ieee-uiuc/arduino-workshop/README.md

# arduino-workshop

The home of the IEEE@UIUC Arduino Workshop! You can find each shield and example code in the appropriate directory.
