ieee-uiuc/arduino-workshop/hardware/Baseline_Shield/Baseline_Shield.md

# Baseline Shield
Arduino shield for the Baseline Arduino workshop, as well as the first breakout session.
  * 6 LED outputs (3 PWM allowed)
  * 2 Buttons (IEEE Logos)
  * Plug-and-play Spot for Servos
  * Other used pins go out to headers
