ieee-uiuc/arduino-workshop/slides/Arduino Workshop Breakout II.pdf

# Arduino Workshop Breakout II

# IEEE Arduino Workshop, Fall 2015 Kashev Dalmia & Brady Salz

Tell Me About You.

- What’s your Year in School?
- Have you Taken…
- ECE 220/190/198kl?
- CS 225?
- ECE 391?
- CS 431?
- ECE 445?
- ECE 310/311?
- Rate Your Experience With…
- Arduino
- C++
- DSP
- Building Stuff

This is us.

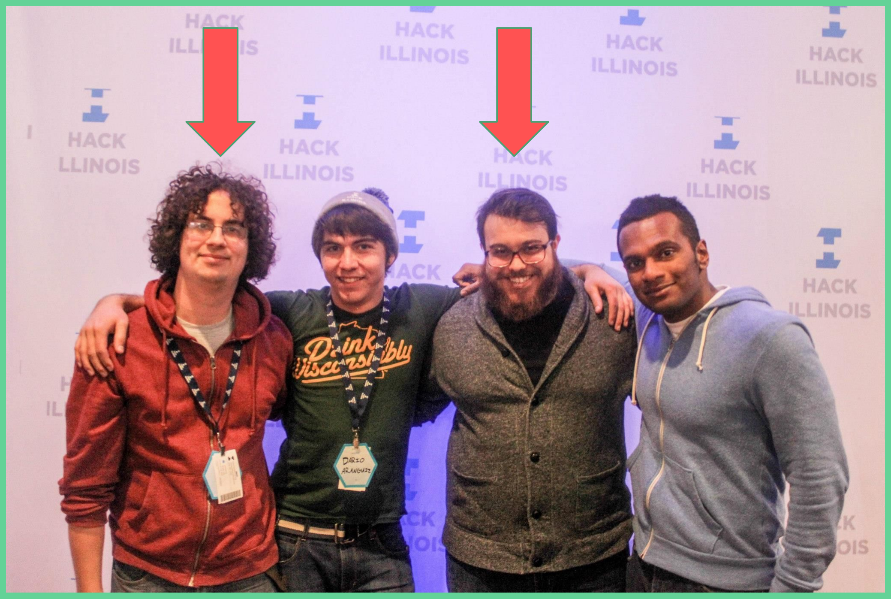
[picture p1: figure]

- Graduate Students
- Brady: Hardware
- Kashev: Software
- Been doing this sort of thing a while.

Today’s Agenda for Breakout II: Learn About...

# - Understanding Hardware+Software Systems - Interacting with more ‘Advanced’ Parts - Writing Good Software

# Understanding Hardware Systems

# Shield System Diagram (HW Design)

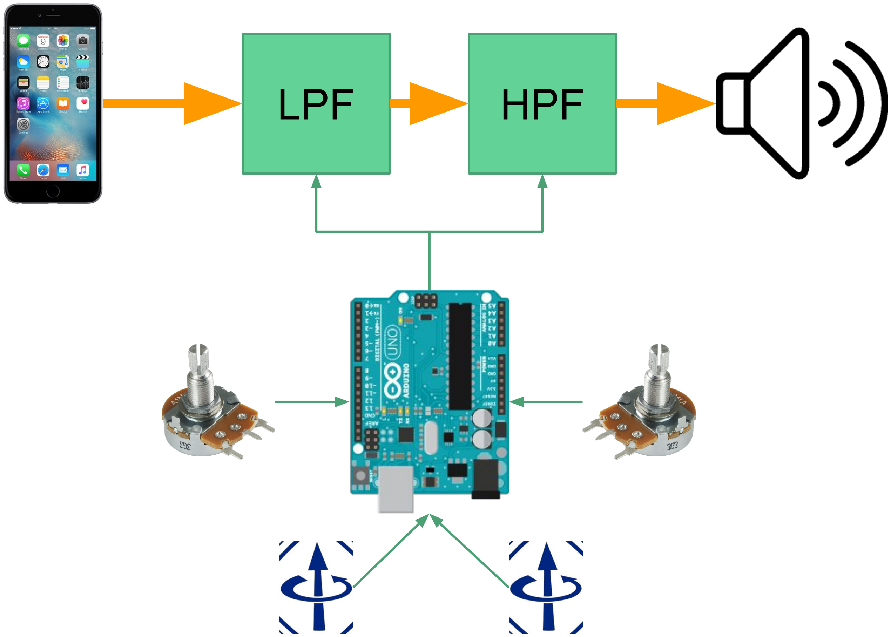
[picture p2: figure]
LPF; HPF

### - This is already done for you!

- Thanks, Brady

### - This is already assembled for you!

- Thanks, Team

### - Things to Think About:

- Why is the audio path not running through the Arduino?
- What are the Inputs to the Arduino?
- What are the Outputs of the Arduino?

# Shield Schematic Overview

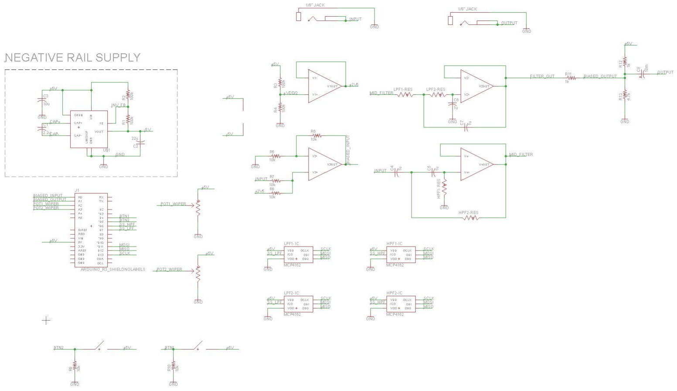
[picture p3: figure]

### - Potentiometers - Digital Resistors - Buttons - Rail Inverter - 2nd Order Filters

# Analog Filtering

### - Two Filters

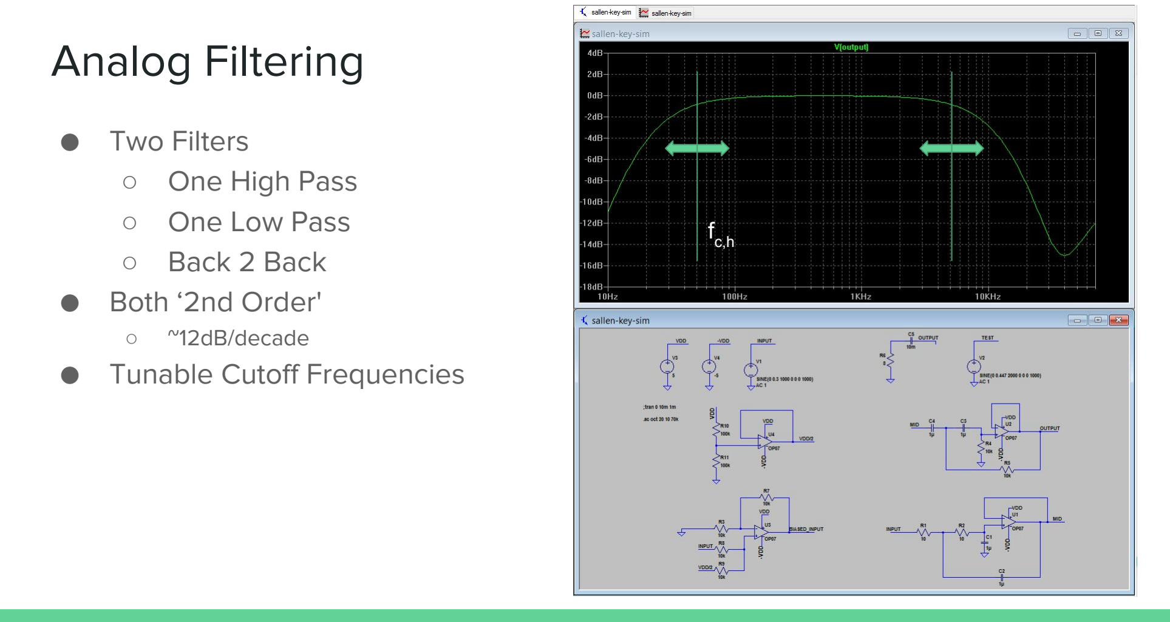
[picture p4: page 8]

### - One High Pass - One Low Pass - Back 2 Back - Both ‘2nd Order'

- ~12dB/decade

### - Tunable Cutoff Frequencies

fc,h

# Digital vs Analog Potentiometers?

### Digital Potentiometers

### - Pros

- Very, very high accuracy
- Very, very high precision

### - Cons

- Have to be programmed
- Low power rating

### Analog Potentiometers

### - Pros

- Fun to use!
- High power rating

### - Cons

- Low precision
- Low accuracy

# Our Goal: Filter The Audio Based On The Position of the

Potentiometers.
The Button States.

# Steps to Accomplish Goals:

### 1. Read The Button State 2. Adjust the Filter Cutoff Frequencies

# Sub-Steps to Accomplish Goals:

### 1. Read The Buttons

a. Read in as Digital Input.

### 2. Adjust the Filter Cutoff Frequency

a. Learn relationship between digital resistors & our filters.
b. Learn to talk to our filters.

# Controlling the Filters

### - Need to move filter cutoffs - -> Need to Change Resistor Values - Our Resistors are Microchip MCP4162s

- Thanks Brady!

### - So How Do We Learn How To Control These?

# Interacting with Advanced Parts

# How do we interact with Advanced Parts?

Read The Datasheet.

## http://ww1.microchip.com/downloads/en/DeviceDoc/22059b.pdf

### - This Datasheet is hard to digest:

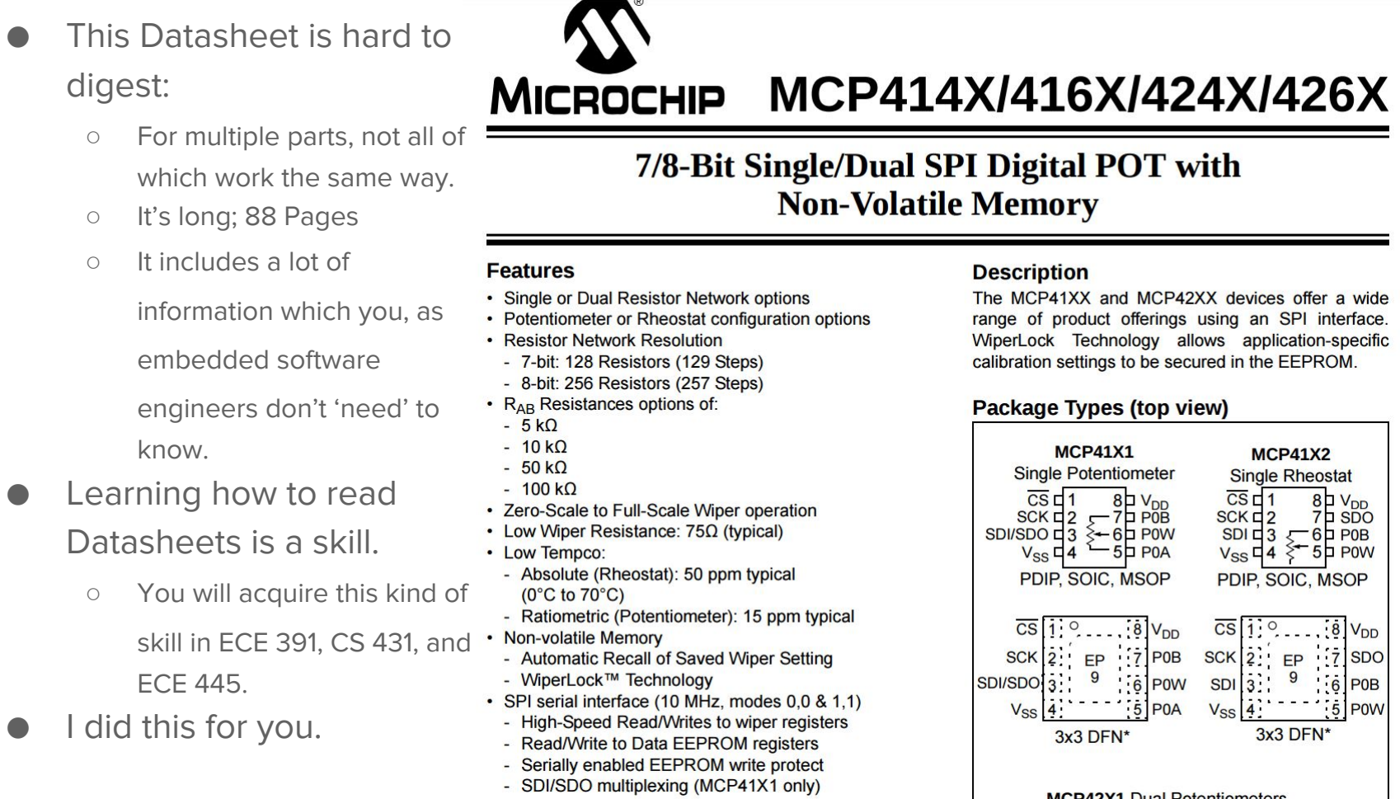
[picture p5: page 17]

- For multiple parts, not all of which work the same way.
- It’s long; 88 Pages
- It includes a lot of

information which you, as

embedded software

engineers don’t ‘need’ to
know.

### - Learning how to read

Datasheets is a skill.

- You will acquire this kind of

skill in ECE 391, CS 431, and ECE 445.
- I did this for you.

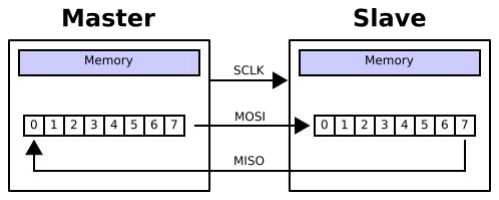
[picture p6: figure]

# Talking to SPI Parts

### - Master and Slave Devices

- Can have multiple slaves on the same SCLK/MOSI/MISO lines.
- Each slave has a chip select

which we can use to tell it to listen.

### - Kind of a loosely defined

protocol.

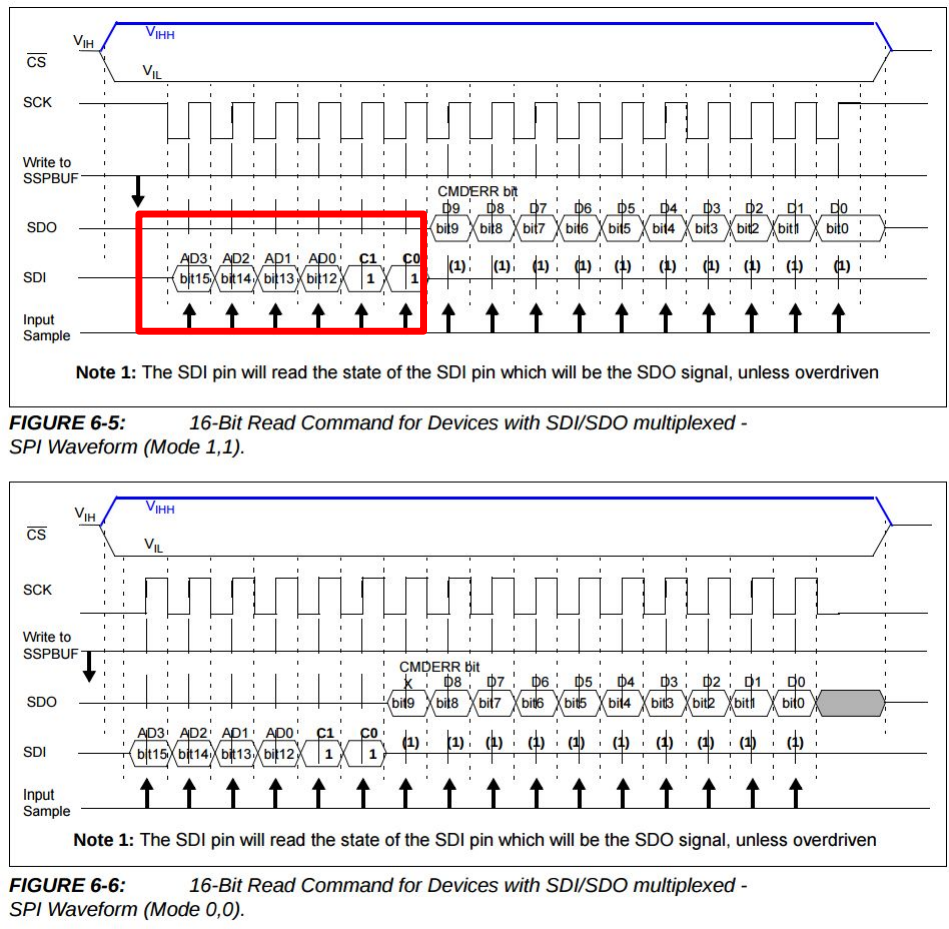
[picture p7: figure]

### - Reading the Datasheet:

- MSB First

### - Reading the Datasheet:

- MSB First
- Mode 11
- 10MHz operation

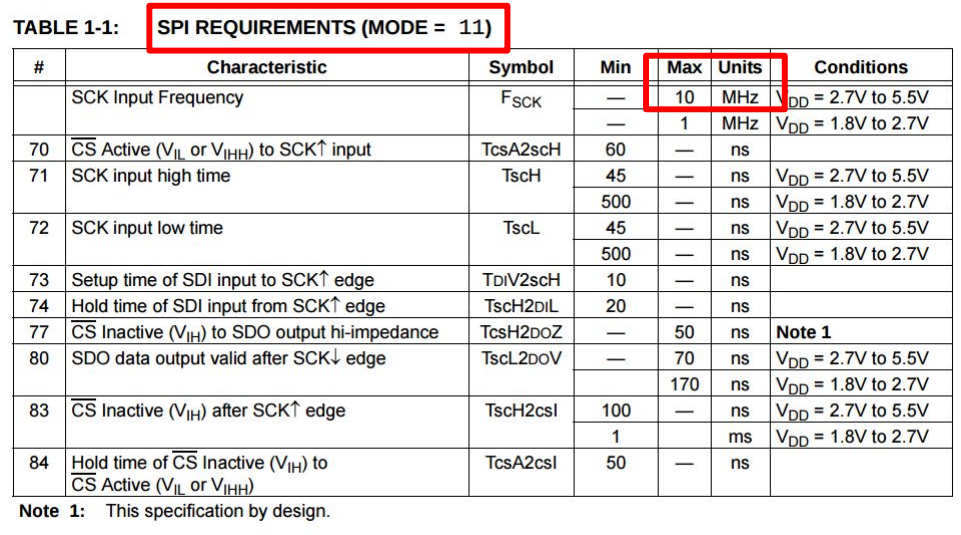
[picture p8: figure]

### - Reading the Datasheet:

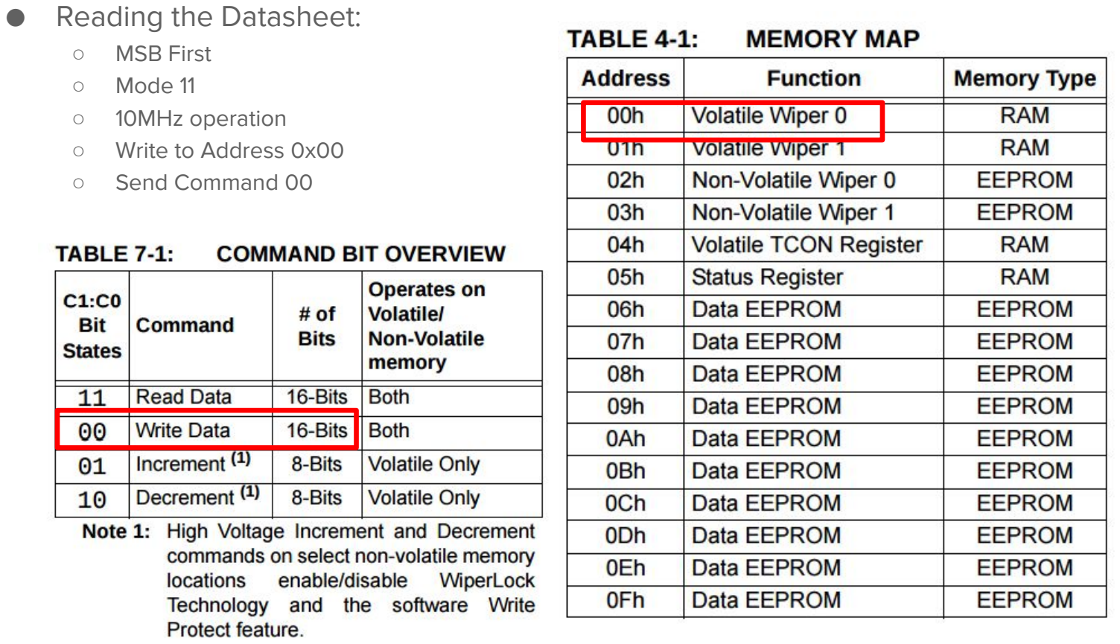
[picture p9: page 21]

- MSB First
- Mode 11
- 10MHz operation
- Write to Address 0x00
- Send Command 00

# So now we implement SPI, right?

# Rule of Software: Don’t Reinvent the Wheel

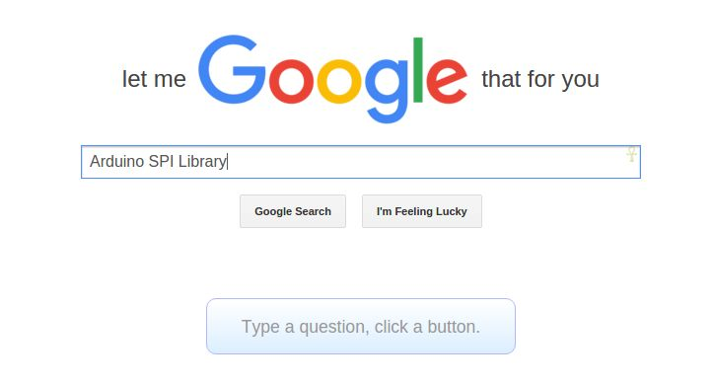
[picture p10: figure]

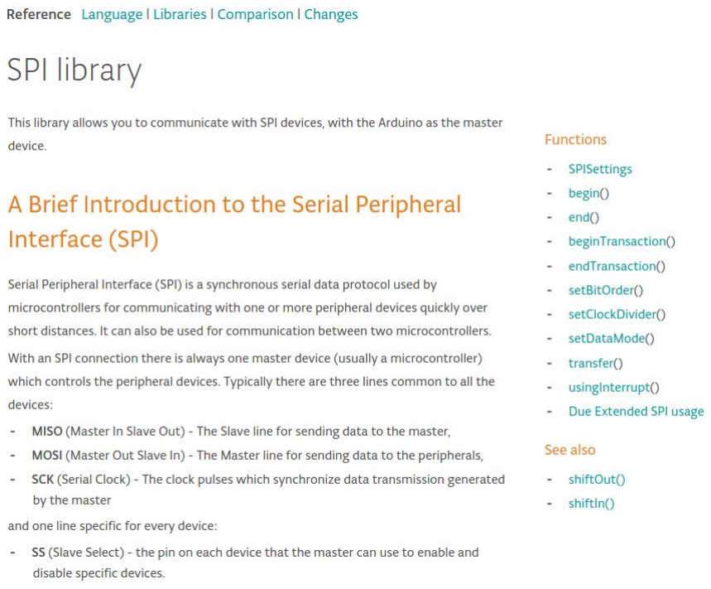
[picture p11: figure]

# Arduino SPI Library

### - Standard, shipping library - Good documentation by Arduino Standards

https://www.arduino.cc/en/Reference/SPI

# Aside: Device Communication Standards

- There are a lot of them.
- You generally should not invent your own communication protocol.
- You generally should not have to write your own communication library.
- SPI
- SSI
- CANN
- I2C
- I2S
- the list goes on and on and on and on

# Writing Good Software

# What Is Good Software?

### 1. Works 2. Readable 3. As Simple as Possible 4. Modular 5. Extensible

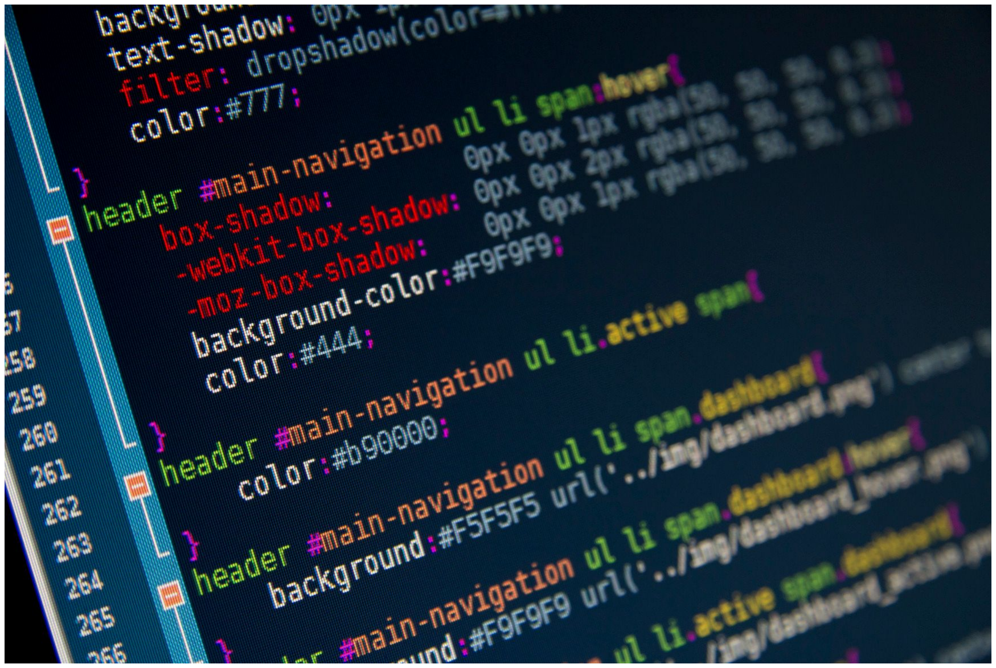
[picture p12: figure]

CSS is almost never good code.

# Why Do We Write Good Software?

### 1. Money

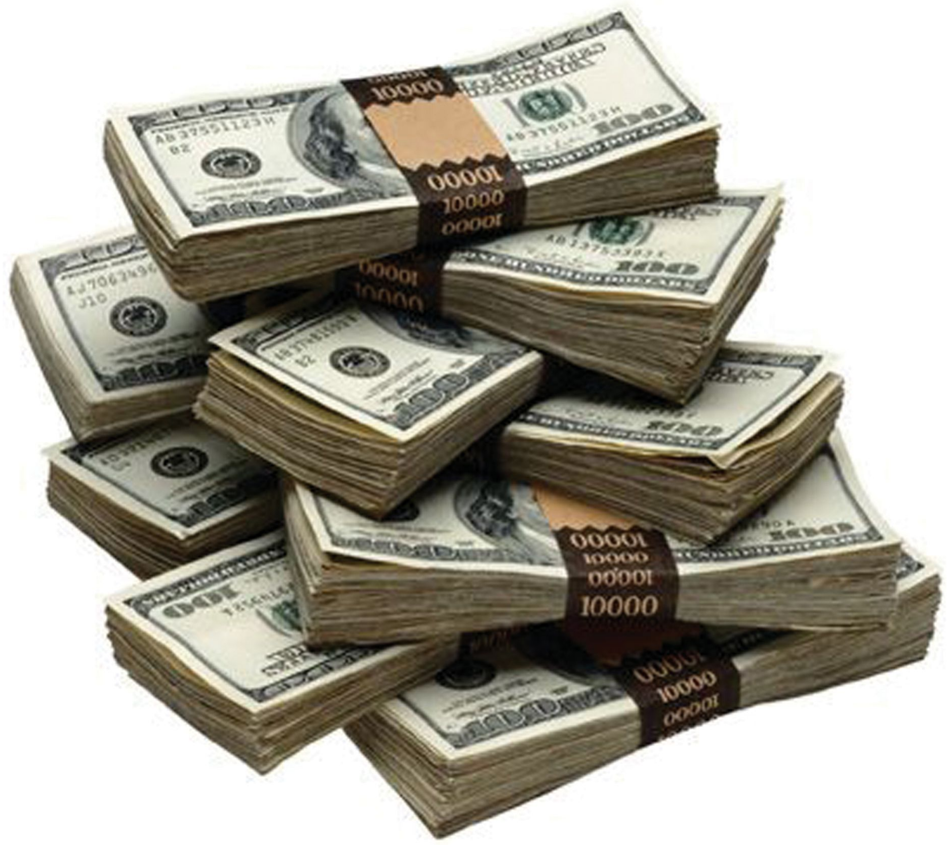
[picture p13: figure]

### 2. Pride 3. Kindness to Ourselves & Others

# Rule of Software: Adhere to A Style

### https://www.arduino.cc/en/Reference/APIStyleGuide

# Arduino: Not C++

# Arduino Uses OOP

### - Object Oriented Programming - Every Physical Thing should also be a Software Thing - You’ll learn about it in CS 225

Resistor | Resistor
LPF | HPF

Shield

# Let’s Talk About the Code

# Appendix + Errata: Using the Potentiometers

# The PCB Shields have a small error which we didn’t have

time to fix.

# Correctly Attaching The Pots

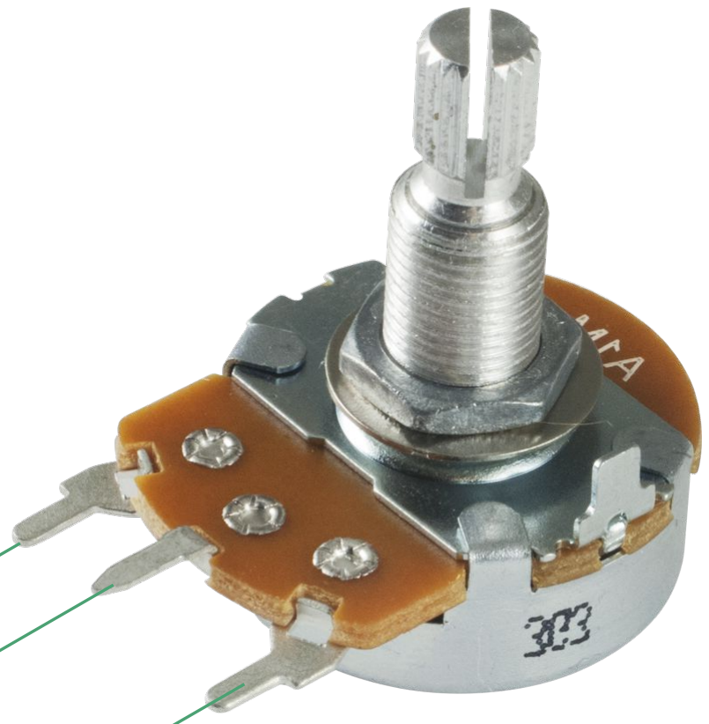
[picture p14: figure]

### Ironically, all the “hard” parts of the board

work fine.

### It’s the easiest part that got messed up

### I mislabeled the “W” and “B” pins

### The fix is simple, just rewire manually

### Simple for one board, obnoxious for fixing 30 of them

### Rework instructions online by end of today

A W
B

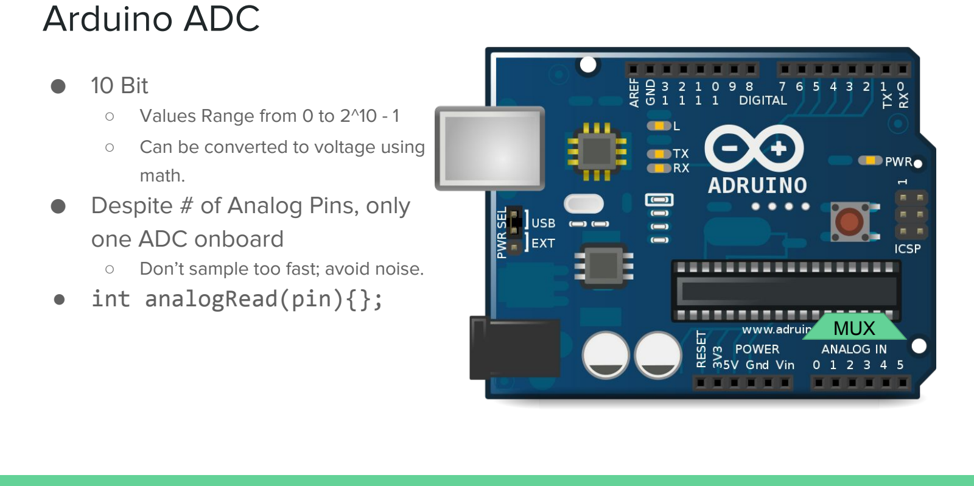
[picture p15: page 36]

Arduino ADC ● 10 Bit ○ | Values Range from 0 to 2^10 - 1 ○ | Can be converted to voltage using

math.

### - Despite # of Analog Pins, only

one ADC onboard ○ Don’t sample too fast; avoid noise.

- int analogRead(pin){};

MUX

### - The potentiometers on your shields are/were on pins A2, A3 - We’ll adapt a sketch to learn

how to do this.

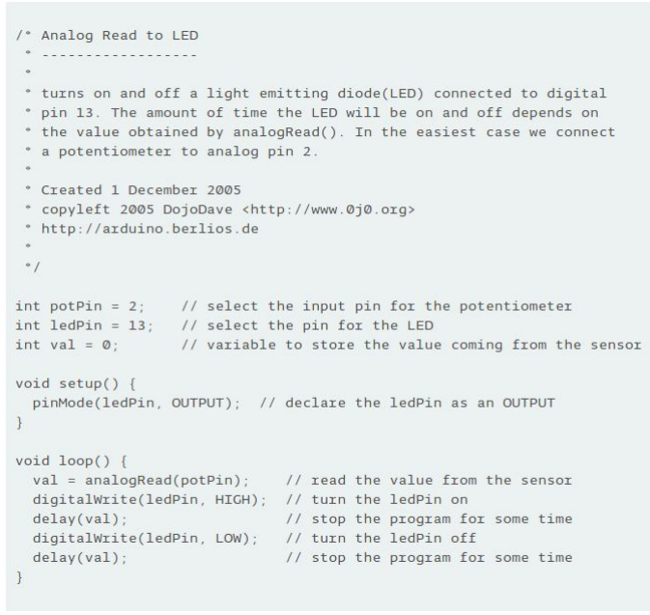
[picture p16: figure]

### arduino.cc/en/Tutorial/Potentiometer

# Reading a Potentiometer
