ieee-uiuc/arduino-workshop/hardware/Advanced_Shield/Advanced_Shield_Board.png

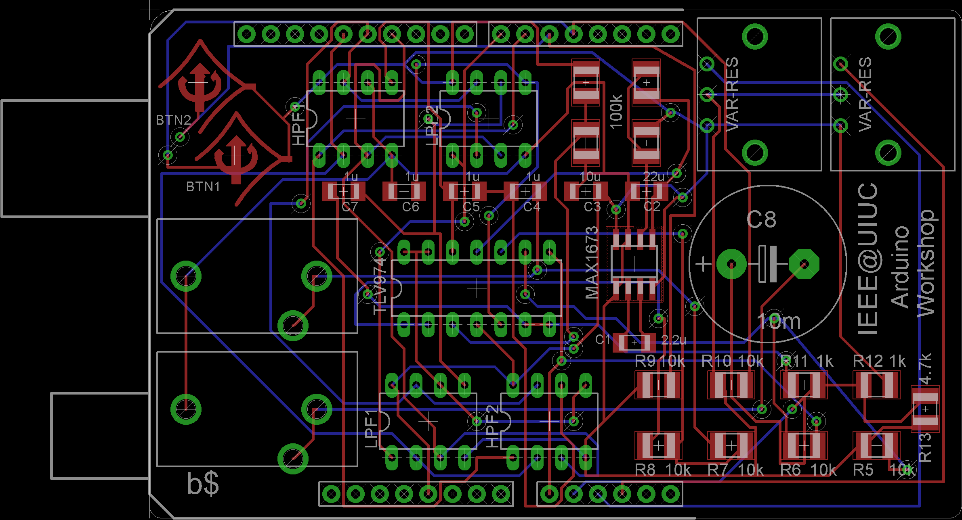
hardware/Advanced_Shield/Advanced_Shield_Board.png
