ieee-uiuc/arduino-workshop/hardware/Advanced_Shield/Advanced_Shield_Schematic.png

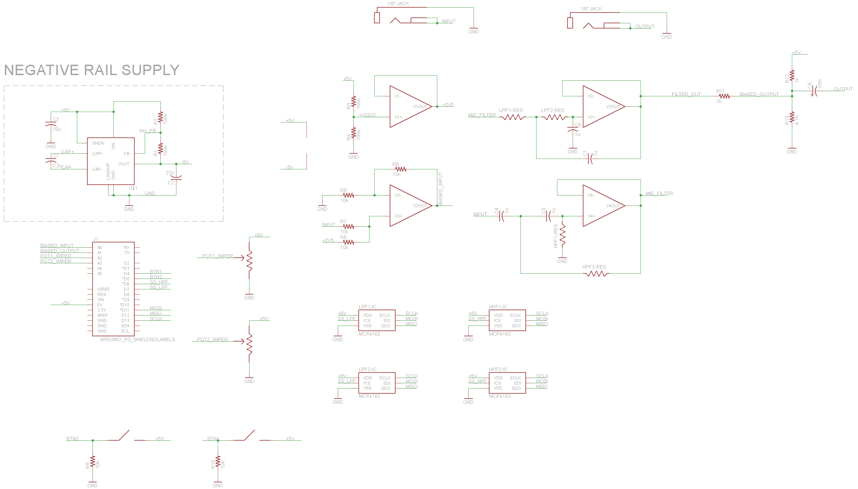
hardware/Advanced_Shield/Advanced_Shield_Schematic.png
