ieee-uiuc/arduino-workshop/hardware/Baseline_Shield/Baseline_Board_Schematic.png

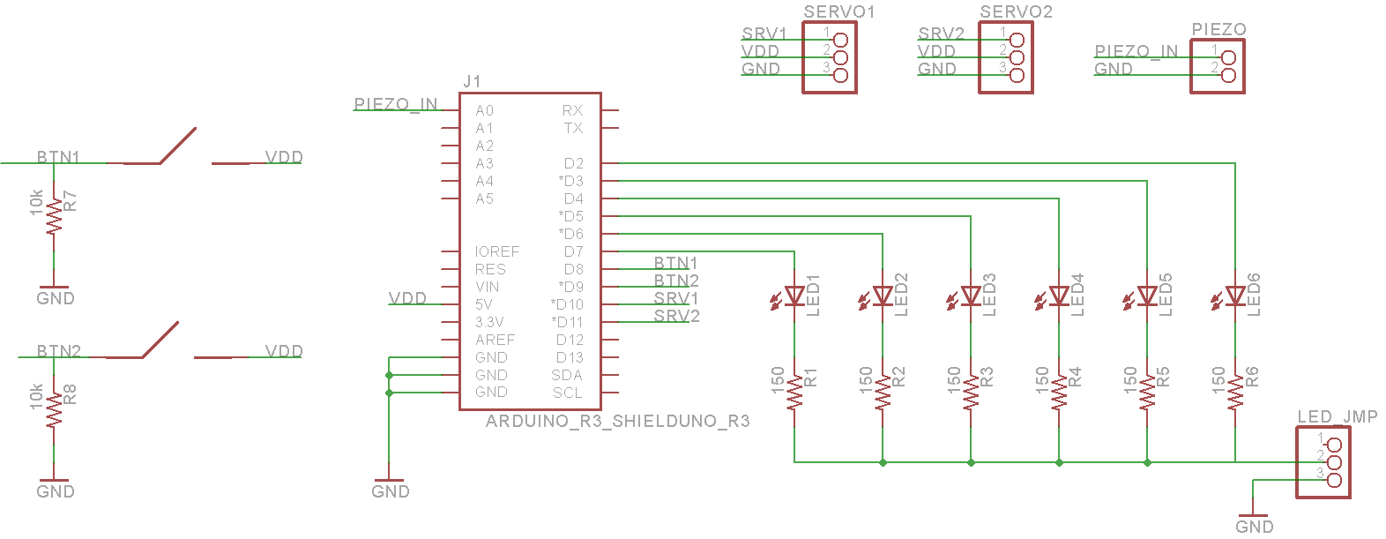
hardware/Baseline_Shield/Baseline_Board_Schematic.png
