ieee-uiuc/arduino-workshop/hardware/Baseline_Shield/Baseline_Shield_Board.png

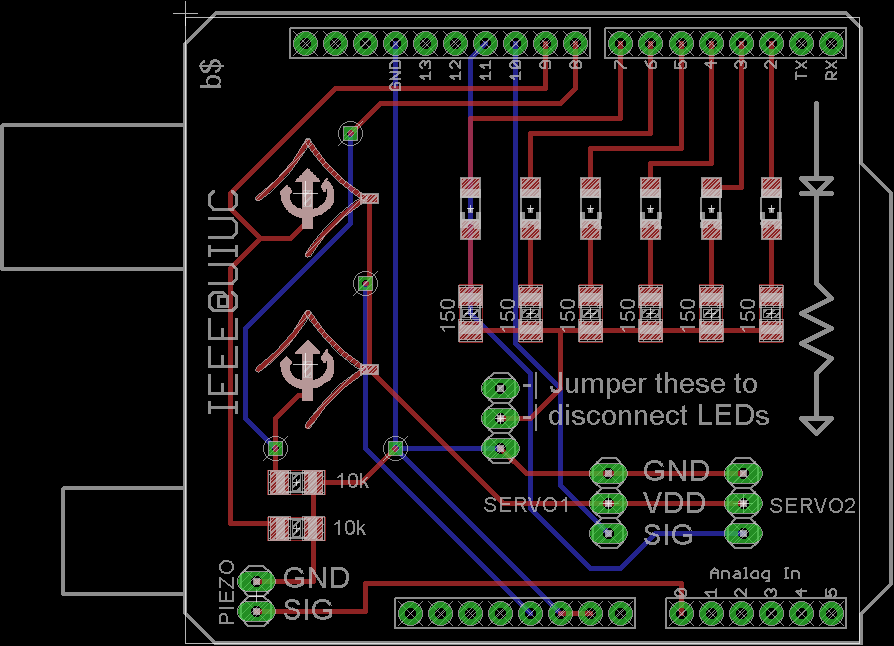
hardware/Baseline_Shield/Baseline_Shield_Board.png
