ieee-uiuc/arduino-workshop/hardware/Advanced_Shield/Advanced_Shield_BOM.xlsx

Schematic Name | Manufacturer PN | Supplier | Vendor PN | Quantity/Brd | Net Quantity | Price | Net Cost | Purpose | URL
1uF | CL31F104MBCNNNC | Digikey | 1276-2854-1-ND | 4 | 132 | $0.02 | $2.55 | SK Filter | http://www.digikey.com/product-detail/en/CL31F104MBCNNNC/1276-2854-1-ND/3890940
10mF Cap | UVR0J103MHD | Digikey | 493-1012-ND | 1 | 33 | $0.68 | $22.57 | AC Couple Output | http://www.digikey.com/product-detail/en/UVR0J103MHD/493-1012-ND/588753
10k Analog Pot | P120PK-F17BR5K | Digikey | 987-1294-ND | 2 | 66 | $0.43 | $28.51 | Manual Tuning | http://www.digikey.com/product-detail/en/P120PK-F17BR5K/987-1294-ND/2408871
1/8" Jack | MJ-3536NG | Digikey | CP-3536NG-ND | 2 | 66 | $0.85 | $56.10 | Audio In/Out | http://www.digikey.com/product-detail/en/MJ-3536NG/CP-3536NG-ND/281265
10k Digital Resistor | MCP4162-502E/P | Digikey | MCP4162-502E/P-ND | 4 | 132 | $0.73 | $96.36 | SK Filter | http://www.digikey.com/product-detail/en/MCP4162-502E%2FP/MCP4162-502E%2FP-ND/1874154
Inverter | MAX1673ESA+ | Digikey | MAX1673ESA+-ND | 1 | 33 | $3.44 | $113.52 | Negative Rail | http://www.digikey.com/product-detail/en/MAX1673ESA%2B/MAX1673ESA%2B-ND/947768
2.2uF Cap | 1206YC225KAT2A | Digikey | 478-5900-1-ND | 1 | 33 | $0.47 | $15.48 | Negative Rail | http://www.digikey.com/product-detail/en/1206YC225KAT2A/478-5900-1-ND/2177832
10uF Cap | 1206YC106KAT2A | Digikey | 478-5725-1-ND | 1 | 33 | $0.80 | $26.24 | Negative Rail | http://www.digikey.com/product-detail/en/1206YC106KAT2A/478-5725-1-ND/2136333
22uF Cap | 12066C226KAT2A | Digikey | 478-5997-1-ND | 1 | 33 | $1.15 | $37.88 | Negative Rail | http://www.digikey.com/product-detail/en/12066C226KAT2A/478-5997-1-ND/2208922
100k Resistor | 311-100KERCT-ND | Digikey | RC1206JR-07100KL | 4 | 132 | $0.01 | $1.31 | Negative Rail / Voltage Buffer | http://www.digikey.com/product-detail/en/RC1206JR-07100KL/311-100KERCT-ND/732154
TLV974 | TL974IN | Digikey | 296-39237-5-ND | 1 | 33 | $0.80 | $26.43 | Quad Op Amp | http://www.digikey.com/product-detail/en/TL974IN/296-39237-5-ND/1675406
10k Resistor | RC1206JR-0710KL | Digikey | 311-10KERCT-ND | 6 | 198 | $0.01 | $1.96 | Input Bias / Button Pull Down | http://www.digikey.com/product-detail/en/RC1206JR-0710KL/311-10KERCT-ND/732156
1k Resistor | RC1206JR-071KL | Digikey | 311-1.0KERCT-ND | 2 | 66 | $0.02 | $1.16 | Output Bias | http://www.digikey.com/product-detail/en/RC1206JR-071KL/311-1.0KERCT-ND/732133
4.7k Resistor | RC1206JR-074K7L | Digikey | 311-4.7KERCT-ND | 1 | 33 | $0.02 | $0.58 | Output Bias | http://www.digikey.com/product-detail/en/RC1206JR-074K7L/311-4.7KERCT-ND/732242
6x1 Male Pin Header | 3-644456-6 | Mouser | 571-3-644456-6 | 1 | 33 | $0.21 | $6.93 | Headers | http://www.mouser.com/ProductDetail/TE-Connectivity/3-644456-6/
8x1 Male Pin Header | 3-644456-8 | Mouser | 571-3-644456-8 | 2 | 66 | $0.47 | $31.09 | Headers | http://www.mouser.com/ProductDetail/TE-Connectivity/3-644456-8/
10x1 Male Pin Header | 1-640456-0 | Mouser | 571-16404560 | 1 | 33 | $0.31 | $10.13 | Headers | http://www.mouser.com/ProductDetail/TE-Connectivity-AMP/1-640456-0/
 |  |  |  |  |  | Total | $478.80
 |  |  |  |  |  | Each | $15.96
