ieee-uiuc/arduino-workshop/hardware/Baseline_Shield/Baseline_Shield_BOM.xlsx

Schematic Name | Manufacturer PN | Vendor PN | Net Quantity | Price | Net Cost | Supplier | URL
2x1 Female Pin Header | PPTC021LFBN-RC | S7000-ND | 110 | $0.228 | $25.08 | Digikey | http://www.digikey.com/product-detail/en/PPTC021LFBN-RC/S7000-ND/810142
Green LED | LTST-C150KGKT | 160-1404-1-ND | 660 | $0.092 | $60.83 | Digikey | http://www.digikey.com/product-detail/en/LTST-C150KGKT/160-1404-1-ND/386759
Jumper | 382811-8 | A26228-ND | 110 | $0.078 | $8.58 | Digikey | http://www.digikey.com/product-detail/en/382811-8/A26228-ND/293121
150 Ohm Res | RC1206JR-07150RL | 311-150ERCT-ND | 660 | $0.006 | $3.97 | Digikey | http://www.digikey.com/product-detail/en/RC1206JR-07150RL/311-150ERCT-ND/732170
10k Ohm Res | RC1206JR-0710KL | 311-10KERCT-ND | 220 | $0.006 | $1.32 | Digikey | http://www.digikey.com/product-detail/en/RC1206JR-0710KL/311-10KERCT-ND/732156
6x1 Male Pin Header | 3-644456-6 | 571-3-644456-6 | 110 | $0.194 | $21.34 | Mouser | http://www.mouser.com/ProductDetail/TE-Connectivity/3-644456-6/
8x1 Male Pin Header | 3-644456-8 | 571-3-644456-8 | 220 | $0.361 | $79.42 | Mouser | http://www.mouser.com/ProductDetail/TE-Connectivity/3-644456-8/
10x1 Male Pin Header | 1-640456-0 | 571-16404560 | 110 | $0.297 | $32.67 | Mouser | http://www.mouser.com/ProductDetail/TE-Connectivity-AMP/1-640456-0/
3x1 Male Pin Header | 4-103321-5 | 571-4-103321-5 | 330 | $0.087 | $28.71 | Mouser | http://www.mouser.com/ProductDetail/TE-Connectivity-AMP/4-103321-5/
Piezo | 7BB-20-6L0 | SEN-10293 | 110 | $1.350 | $148.50 | Sparkfun | https://www.sparkfun.com/products/10293
 |  |  |  | Total | $410.42
 |  |  |  | Price/Brd | $4.10
