ieee-uiuc/arduino-workshop/hardware/Advanced_Shield/sallen-key-sim.asc

C1: cap; 1µ
C2: cap; 1µ
C3: cap; 1µ
C4: cap; 1µ
C5: cap; 10m
R1: res; 10
R2: res; 10
R3: res; 10k
R4: res; 10k
R5: res; 10k
R6: res; 8
R7: res; 10k
R8: res; 10k
R9: res; 10k
R10: res; 100k
R11: res; 100k
R12: res
R13: res
R14: res
U1: OP07
U2: OP07
U3: OP07
U4: OP07
V1: voltage; SINE(0 0.3 1000 0 0 0 1000); AC 1
V2: voltage; SINE(0 0.447 2000 0 0 0 1000); AC 1
V3: voltage; 5
V4: voltage; -5
Named nets: 0, VDD, MID, INPUT, OUTPUT, VDD/2, BIASED_INPUT, TEST, -VDD
.tran 0 10m 1m
;ac oct 20 10 40k
