ieee-uiuc/arduino-workshop/hardware/Baseline_Shield/Baseline_Shield.brd

## EAGLE design hardware/Baseline_Shield/Baseline_Shield.brd (2015-10-08)

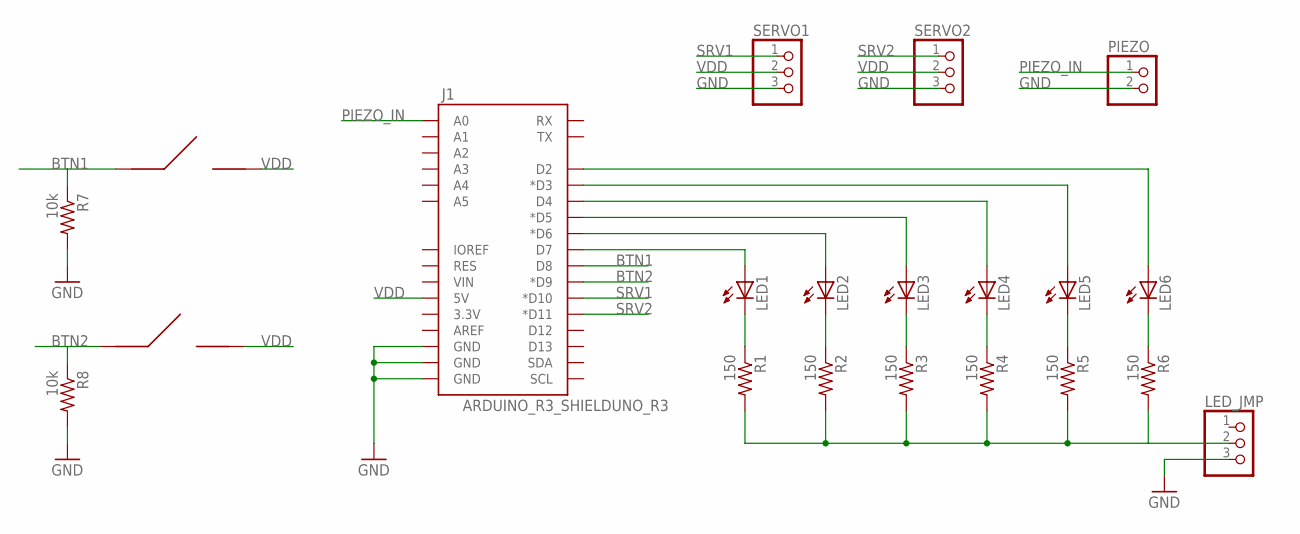
[picture p21: schematic Baseline_Shield.sch]

Parts:
J1: ARDUINO_R3_SHIELDUNO_R3; UNO_R3_SHIELD
LED1, LED2, LED3, LED4, LED5, LED6: LEDCHIPLED_1206; CHIPLED_1206
LED_JMP: PINHD-1X3; 1X03
PIEZO: PINHD-1X2; 1X02
R1, R2, R3, R4, R5, R6: 150; R1206
R7, R8: 10k; R1206
SERVO1, SERVO2: PINHD-1X3; 1X03
U$1, U$2: IEEE_LOGO_BUTTON

Connections:
BTN1: J1.D8, R7.1, U$2.P$1
BTN2: J1.D9 (*D9), R8.1, U$1.P$1
GND: J1.GND@0 (GND), J1.GND@1 (GND), J1.GND@2 (GND), LED_JMP.3, PIEZO.2, R7.2, R8.2, SERVO1.3, SERVO2.3
unnamed: J1.D2, LED6.A
unnamed: J1.D3 (*D3), LED5.A
unnamed: J1.D4, LED4.A
unnamed: J1.D5 (*D5), LED3.A
unnamed: J1.D6 (*D6), LED2.A
unnamed: J1.D7, LED1.A
unnamed: LED1.C, R1.1
unnamed: LED2.C, R2.1
unnamed: LED3.C, R3.1
unnamed: LED4.C, R4.1
unnamed: LED5.C, R5.1
unnamed: LED6.C, R6.1
unnamed: LED_JMP.2, R1.2, R2.2, R3.2, R4.2, R5.2, R6.2
PIEZO_IN: J1.A0, PIEZO.1
SRV1: J1.D10 (*D10), SERVO1.1
SRV2: J1.D11 (*D11), SERVO2.1
VDD: J1.5V, SERVO1.2, SERVO2.2, U$1.P$2, U$2.P$2

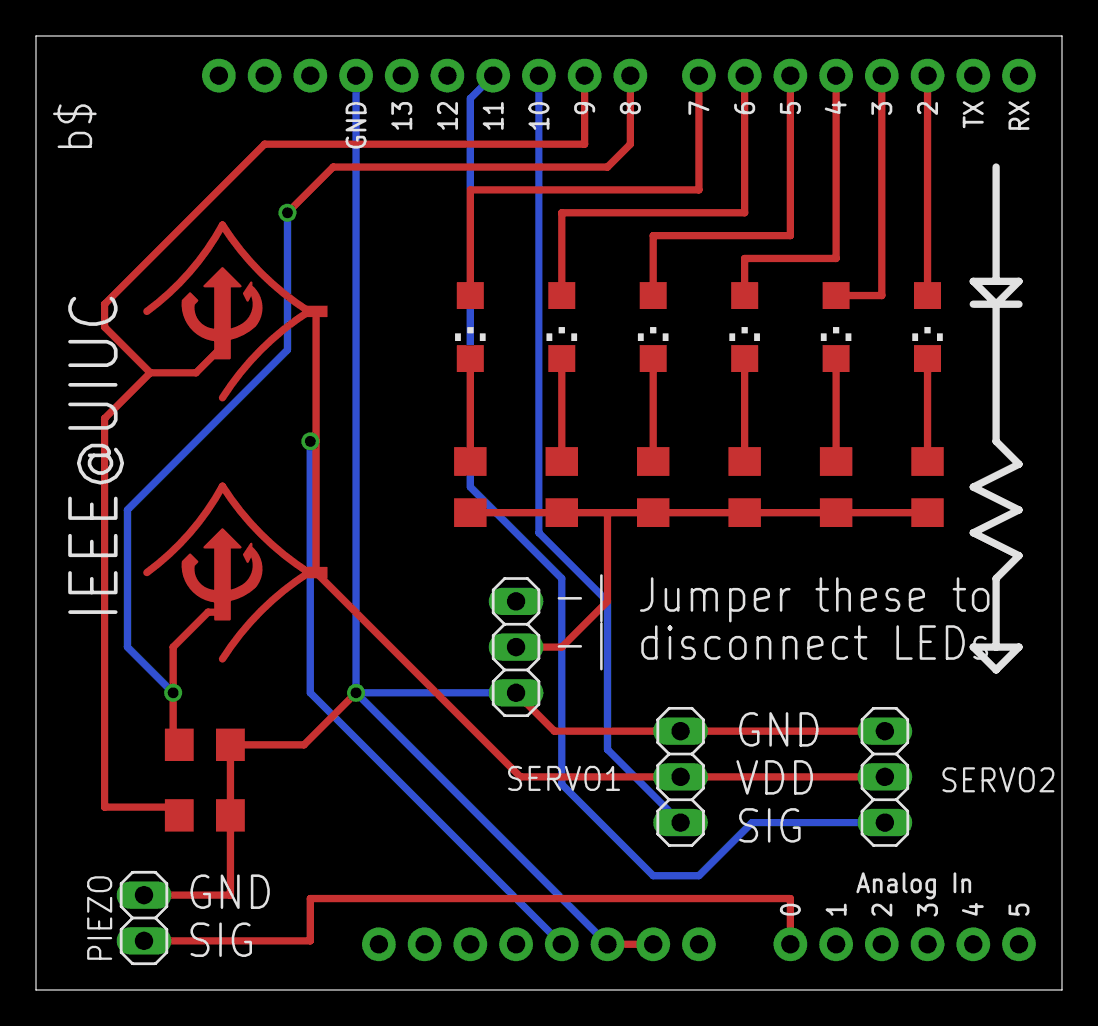
[picture p22: board Baseline_Shield.brd from above]

Board: 2 copper layers, 57.0 x 53.0 mm, 21 parts (0 on the bottom side), 20 nets.
