ieee-uiuc/arduino-workshop/hardware/Advanced_Shield/Advanced_Breakout_Schematic.brd

## EAGLE design hardware/Advanced_Shield/Advanced_Breakout_Schematic.brd (2015-10-14)

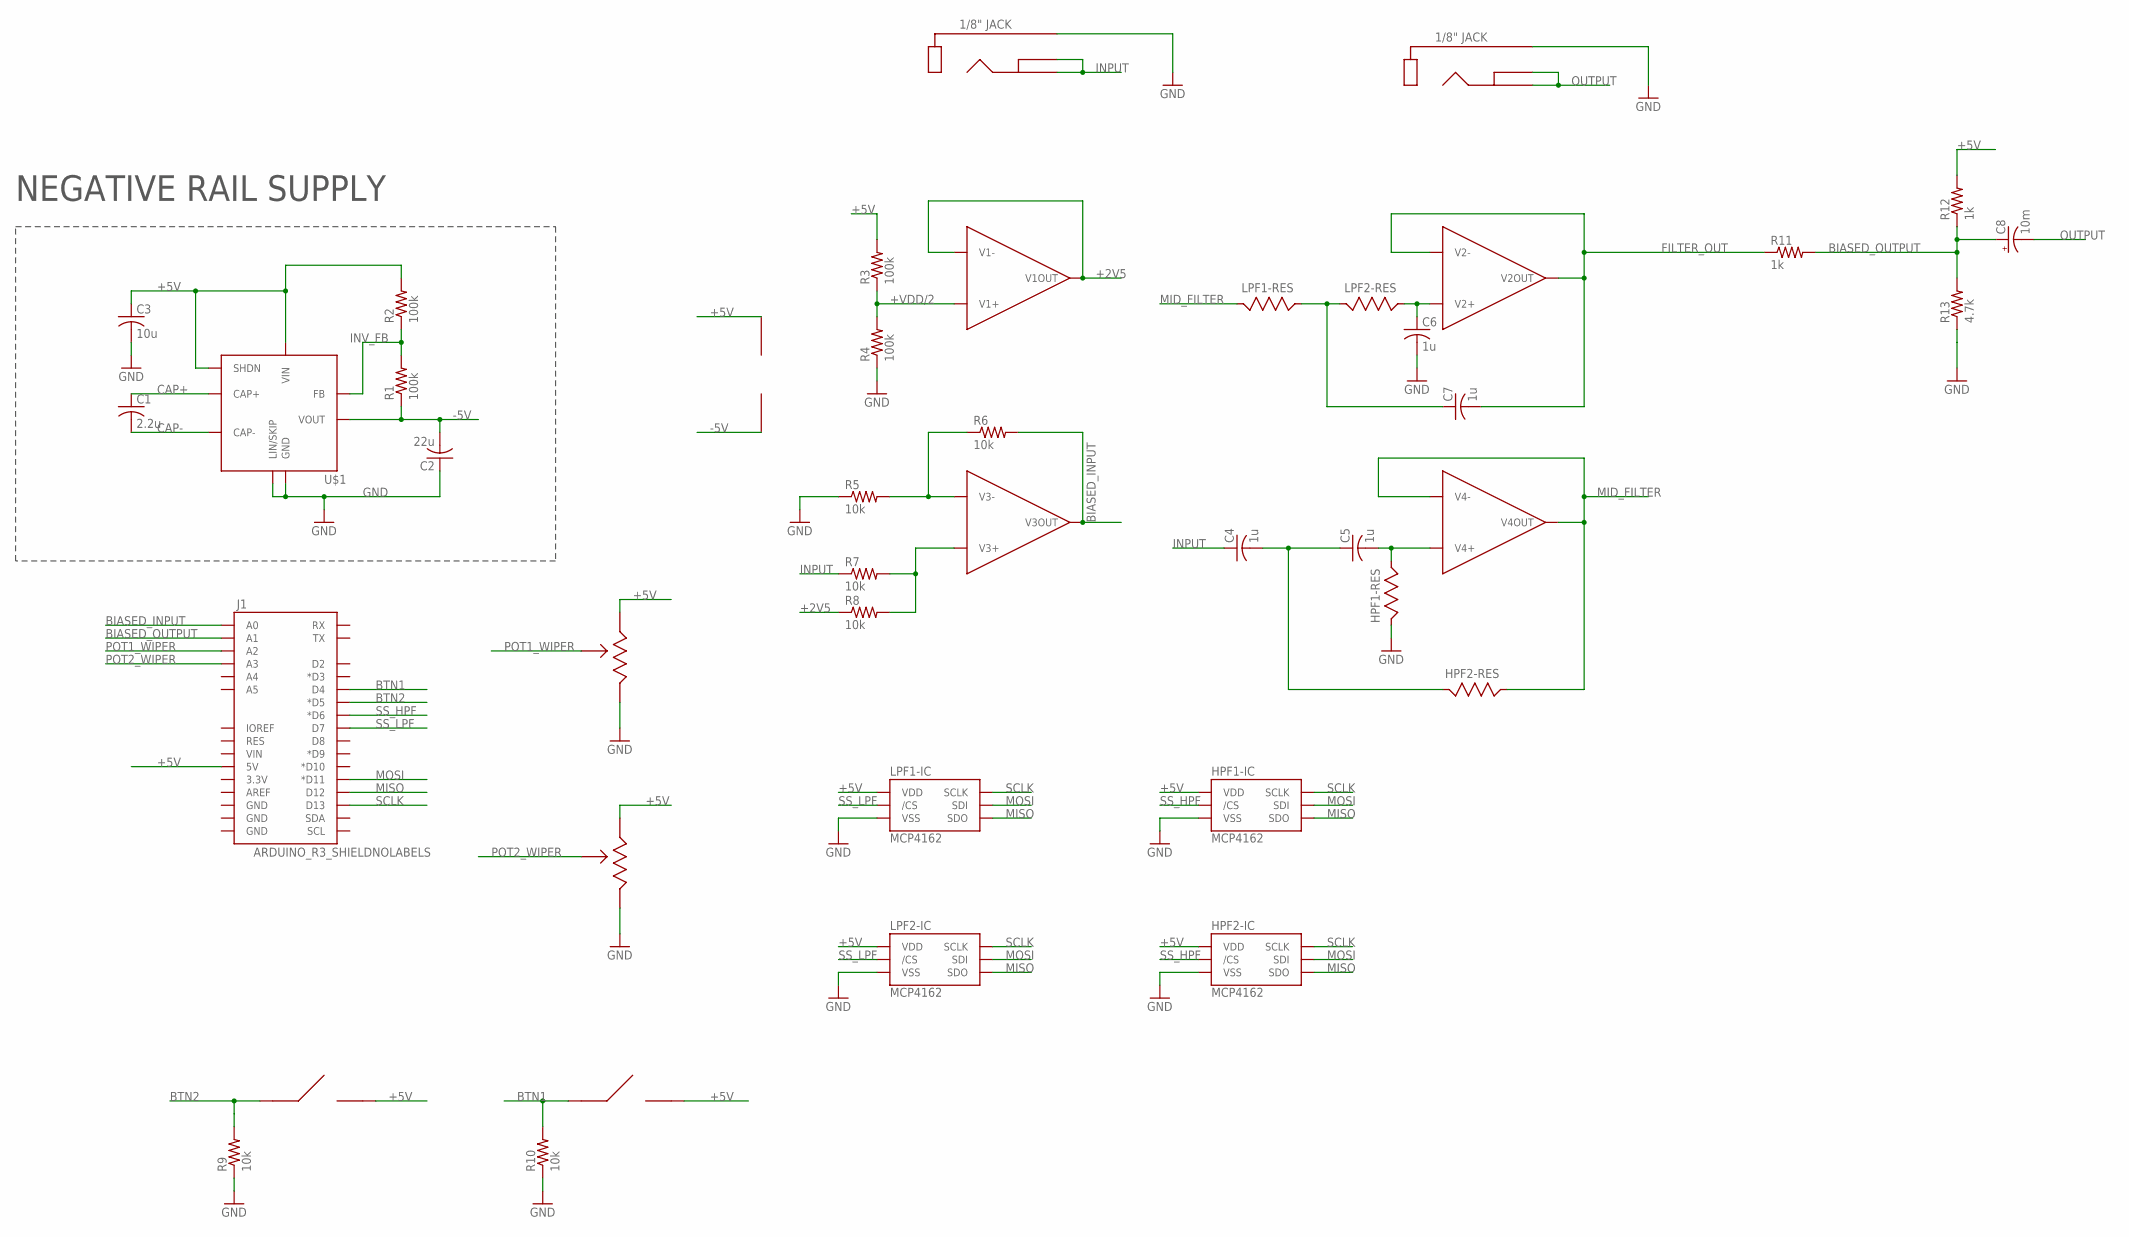
[picture p23: schematic Advanced_Breakout_Shield.sch]

Parts:
C1: 2.2u; C1206K
C2: 22u; C1206K
C3: 10u; C1206K
C4, C5, C6, C7: 1u; C1206K
C8: 10m; E7,5-16
HPF1, HPF2: MCP4162-502E; DIL08
J1: ARDUINO_R3_SHIELDNOLABELS; UNO_R3_SHIELD_NOLABELS
LPF1, LPF2: MCP4162-502E; DIL08
R1, R2, R3, R4: 100k; R1210
R5, R6, R7, R8, R9, R10: 10k; R1210
R11, R12: 1k; R1210
R13: 4.7k; R1210
U$1: MAX1673; SO08
U$2: TLV974; DIL14
U$3, U$4: P120PK
U$5, U$6: AUDIO_JACK
U$7, U$8: IEEE_LOGO_BUTTON

Connections:
+2V5: R8.1, U$2.1 (V1OUT), U$2.2 (V1-)
+5V: C3.1, HPF1.8 (VDD), HPF2.8 (VDD), J1.5V, LPF1.8 (VDD), LPF2.8 (VDD), R2.2, R3.2, R12.2, U$1.4 (SHDN), U$1.8 (VIN), U$2.4 (+VCC), U$3.PR (RA), U$4.PR (RA), U$7.P$2, U$8.P$2
+VDD/2: R3.1, R4.2, U$2.3 (V1+)
-5V: C2.2, R1.1, U$1.5 (VOUT), U$2.11 (-VCC)
BIASED_INPUT: J1.A0, R6.2, U$2.8 (V3OUT)
BIASED_OUTPUT: C8.+, J1.A1, R11.2, R12.1, R13.2
BTN1: J1.D4, R10.2, U$8.P$1
BTN2: J1.D5 (*D5), R9.2, U$7.P$1
CAP+: C1.1, U$1.2 (CAP+)
CAP-: C1.2, U$1.3 (CAP-)
FILTER_OUT: C7.2, R11.1, U$2.6 (V2-), U$2.7 (V2OUT)
GND: C2.1, C3.2, C6.2, HPF1.4 (VSS), HPF1.6 (BASE), HPF2.4 (VSS), LPF1.4 (VSS), LPF2.4 (VSS), R4.1, R5.1, R9.1, R10.1, R13.1, U$1.1 (LIN/SKIP), U$1.7 (GND), U$3.PM (RB), U$4.PM (RB), U$5.SLEEVE, U$6.SLEEVE
INPUT: C4.1, R7.1, U$5.RING, U$5.TIP
INV_FB: R1.2, R2.1, U$1.6 (FB)
MID_FILTER: HPF2.5 (WIPER), LPF1.6 (BASE), U$2.13 (V4-), U$2.14 (V4OUT)
MISO: HPF1.7 (SDO), HPF2.7 (SDO), J1.D12, LPF1.7 (SDO), LPF2.7 (SDO)
MOSI: HPF1.3 (SDI), HPF2.3 (SDI), J1.D11 (*D11), LPF1.3 (SDI), LPF2.3 (SDI)
unnamed: R5.2, R6.1, U$2.9 (V3-)
unnamed: C5.2, HPF1.5 (WIPER), U$2.12 (V4+)
unnamed: R7.2, R8.2, U$2.10 (V3+)
unnamed: C4.2, C5.1, HPF2.6 (BASE)
unnamed: C6.1, LPF2.5 (WIPER), U$2.5 (V2+)
unnamed: C7.1, LPF1.5 (WIPER), LPF2.6 (BASE)
OUTPUT: C8.-, U$6.RING, U$6.TIP
POT1_WIPER: J1.A2, U$3.PL (RW)
POT2_WIPER: J1.A3, U$4.PL (RW)
SCLK: HPF1.2 (SCLK), HPF2.2 (SCLK), J1.D13, LPF1.2 (SCLK), LPF2.2 (SCLK)
SS_HPF: HPF1.1 (/CS), HPF2.1 (/CS), J1.D6 (*D6)
SS_LPF: J1.D7, LPF1.1 (/CS), LPF2.1 (/CS)

Notes on the sheet:
NEGATIVE RAIL SUPPLY

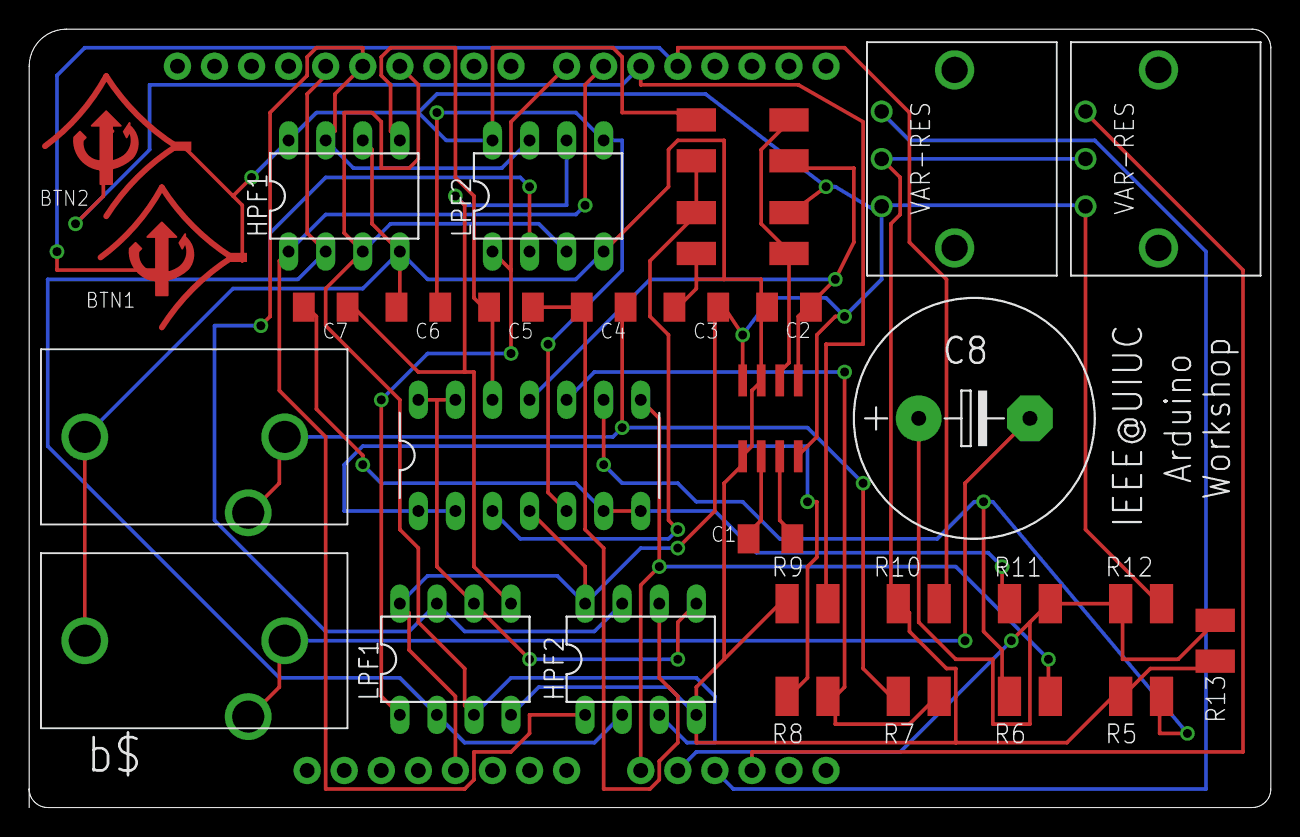
[picture p24: board Advanced_Breakout_Schematic.brd from above]

Board: 2 copper layers, 85.1 x 53.3 mm, 34 parts (0 on the bottom side), 29 nets.
