ieee-uiuc/arduino-workshop/(commit log)

2015-10-06 bom commit
    [Baseline_Shield_BOM.xlsx]
2015-10-06 updated bom
    [Baseline_Shield_BOM.xlsx]
2015-10-07 make bom clearer and pushed filter code
    [Baseline_Shield_BOM.xlsx]
2015-10-07 cleaning up the repo
    there's a new sheriff in town
    [Baseline_Shield_BOM.xlsx]
2015-10-08 baseline shield eagle files
    [Baseline_Shield.brd, Baseline_Shield.sch]
2015-10-14 filter sims
2015-10-14 advanced BOM
    [Advanced_Shield_BOM.xlsx]
2015-10-14 advanced shield
    [Advanced_Breakout_Shield.brd, Advanced_Breakout_Shield.sch]
2015-10-14 forgot the headers
    [Advanced_Shield_BOM.xlsx]
2015-10-25 Change code to do a full revolution on button press
2015-10-25 moved files to correct places
    [Advanced_Shield_BOM.xlsx, Baseline_Shield_BOM.xlsx]
2015-10-25 renamed + added rework
    [Advanced_Breakout_Schematic.brd]
2015-11-02 Update breakout1 code and upload example solution to LED challenge
